alexander1810/Diplom/(list of files, drawings)

Other design files:
Diplom_test.pdsprj
