alexander1810/Diplom/Diplom/Diplom.ioc

Mcu.UserName=STM32F103C8Tx
PA10.GPIO_Label=PWM_PUMP
PA10.Signal=GPIO_Output
PA11.Signal=S_TIM1_CH4
PA13.Signal=SYS_JTMS-SWDIO
PA14.Signal=SYS_JTCK-SWCLK
PA2.Signal=USART2_TX
PA3.Signal=USART2_RX
PA4.Signal=ADCx_IN4
PA5.Signal=ADCx_IN5
PA6.Signal=ADCx_IN6
PA7.GPIO_Label=PWM_SWITCH
PA7.Signal=GPIO_Output
PA8.GPIO_Label=CONTROL_CH_HEATER
PA8.Signal=GPIO_Output
PA9.GPIO_Label=CONTROL_FAN
PA9.Signal=GPIO_Output
PB0.GPIO_Label=CONTROL_Cooler
PB0.Signal=GPIO_Output
PB1.GPIO_Label=CONTROL_Hum
PB1.Signal=GPIO_Output
PB10.GPIO_Label=CONTROL_WPoolPump
PB10.Signal=GPIO_Output
PB11.GPIO_Label=CONTROL_WH
PB11.Signal=GPIO_Output
PB3.Signal=GPXTI3
PC13-TAMPER-RTC.Signal=GPIO_Output
PC14-OSC32_IN.Signal=RCC_OSC32_IN
PC15-OSC32_OUT.Signal=RCC_OSC32_OUT
PD0-OSC_IN.Signal=RCC_OSC_IN
PD1-OSC_OUT.Signal=RCC_OSC_OUT
