alexander1810/Diplom/Diplom/Inc/main.h

#define BUF_SIZE 256
#define POOLTEMP_UPLIM 26
#define POOLTEMP_LOWLIM 24
#define PWM_SWITCH_Pin GPIO_PIN_7
#define PWM_SWITCH_GPIO_Port GPIOA
#define CONTROL_Cooler_Pin GPIO_PIN_0
#define CONTROL_Cooler_GPIO_Port GPIOB
#define CONTROL_Hum_Pin GPIO_PIN_1
#define CONTROL_Hum_GPIO_Port GPIOB
#define CONTROL_WPoolPump_Pin GPIO_PIN_10
#define CONTROL_WPoolPump_GPIO_Port GPIOB
#define CONTROL_WH_Pin GPIO_PIN_11
#define CONTROL_WH_GPIO_Port GPIOB
#define CONTROL_CH_HEATER_Pin GPIO_PIN_8
#define CONTROL_CH_HEATER_GPIO_Port GPIOA
#define CONTROL_FAN_Pin GPIO_PIN_9
#define CONTROL_FAN_GPIO_Port GPIOA
#define PWM_PUMP_Pin GPIO_PIN_10
#define PWM_PUMP_GPIO_Port GPIOA
