alexander1810/Diplom/Diplom/Src/usart.c

/**
  ******************************************************************************
  * File Name          : USART.c
  * Description        : This file provides code for the configuration
  *                      of the USART instances.
  ******************************************************************************
  * @attention
  *
  * <h2><center>&copy; Copyright (c) 2020 STMicroelectronics.
  * All rights reserved.</center></h2>
  *
  * This software component is licensed by ST under BSD 3-Clause license,
  * the "License"; You may not use this file except in compliance with the
  * License. You may obtain a copy of the License at:
  *                        opensource.org/licenses/BSD-3-Clause
  *
  ******************************************************************************
  */

/* Includes ------------------------------------------------------------------*/
#include "usart.h"

/* USER CODE BEGIN 0 */
/////////////////// GSM USART /////////////////////
volatile gsm_rx_buffer_index_t gsm_rx_buffer_head = 0;
volatile gsm_rx_buffer_index_t gsm_rx_buffer_tail = 0;
uint8_t gsm_rx_buffer[GSM_RX_BUFFER_SIZE] = {0,};

int16_t gsm_available(void)
{
	return ((uint16_t)(GSM_RX_BUFFER_SIZE + gsm_rx_buffer_head - gsm_rx_buffer_tail)) % GSM_RX_BUFFER_SIZE;
}

int16_t gsm_read(void)
{
	if(gsm_rx_buffer_head == gsm_rx_buffer_tail)
	{
		return -1;
	}
	else
	{
		unsigned char c = gsm_rx_buffer[gsm_rx_buffer_tail];
		gsm_rx_buffer_tail = (gsm_rx_buffer_index_t)(gsm_rx_buffer_tail + 1) % GSM_RX_BUFFER_SIZE;
		return c;
	}
}

/////////////////// DEBUG USART //////////////////// можно удалить после отладки всего

volatile dbg_rx_buffer_index_t dbg_rx_buffer_head = 0;
volatile dbg_rx_buffer_index_t dbg_rx_buffer_tail = 0;
uint8_t dbg_rx_buffer[DBG_RX_BUFFER_SIZE] = {0,};

int16_t dbg_available(void)
{
	return ((uint16_t)(DBG_RX_BUFFER_SIZE + dbg_rx_buffer_head - dbg_rx_buffer_tail)) % DBG_RX_BUFFER_SIZE;
}

int16_t dbg_read(void)
{
	if(dbg_rx_buffer_head == dbg_rx_buffer_tail)
	{
		return -1;
	}
	else
	{
		uint8_t c = dbg_rx_buffer[dbg_rx_buffer_tail];
		dbg_rx_buffer_tail = (dbg_rx_buffer_index_t)(dbg_rx_buffer_tail + 1) % DBG_RX_BUFFER_SIZE;
		return c;
	}
}

/* USER CODE END 0 */

UART_HandleTypeDef huart2;
DMA_HandleTypeDef hdma_usart2_rx;

/* USART2 init function */

void MX_USART2_UART_Init(void)
{

  huart2.Instance = USART2;
  huart2.Init.BaudRate = 9600;
  huart2.Init.WordLength = UART_WORDLENGTH_8B;
  huart2.Init.StopBits = UART_STOPBITS_1;
  huart2.Init.Parity = UART_PARITY_NONE;
  huart2.Init.Mode = UART_MODE_TX_RX;
  huart2.Init.HwFlowCtl = UART_HWCONTROL_NONE;
  huart2.Init.OverSampling = UART_OVERSAMPLING_16;
  if (HAL_UART_Init(&huart2) != HAL_OK)
  {
    Error_Handler();
  }

}

void HAL_UART_MspInit(UART_HandleTypeDef* uartHandle)
{

  GPIO_InitTypeDef GPIO_InitStruct = {0};
  if(uartHandle->Instance==USART2)
  {
    /* USART2 clock enable */
    __HAL_RCC_USART2_CLK_ENABLE();
  
    __HAL_RCC_GPIOA_CLK_ENABLE();
    /**USART2 GPIO Configuration    
    PA2     ------> USART2_TX
    PA3     ------> USART2_RX 
    */
    GPIO_InitStruct.Pin = GPIO_PIN_2;
    GPIO_InitStruct.Mode = GPIO_MODE_AF_PP;
    GPIO_InitStruct.Speed = GPIO_SPEED_FREQ_HIGH;
    HAL_GPIO_Init(GPIOA, &GPIO_InitStruct);

    GPIO_InitStruct.Pin = GPIO_PIN_3;
    GPIO_InitStruct.Mode = GPIO_MODE_INPUT;
    GPIO_InitStruct.Pull = GPIO_NOPULL;
    HAL_GPIO_Init(GPIOA, &GPIO_InitStruct);

    /* USART2 DMA Init */
    /* USART2_RX Init */
    hdma_usart2_rx.Instance = DMA1_Channel6;
    hdma_usart2_rx.Init.Direction = DMA_PERIPH_TO_MEMORY;
    hdma_usart2_rx.Init.PeriphInc = DMA_PINC_DISABLE;
    hdma_usart2_rx.Init.MemInc = DMA_MINC_ENABLE;
    hdma_usart2_rx.Init.PeriphDataAlignment = DMA_PDATAALIGN_BYTE;
    hdma_usart2_rx.Init.MemDataAlignment = DMA_MDATAALIGN_BYTE;
    hdma_usart2_rx.Init.Mode = DMA_CIRCULAR;
    hdma_usart2_rx.Init.Priority = DMA_PRIORITY_LOW;
    if (HAL_DMA_Init(&hdma_usart2_rx) != HAL_OK)
    {
      Error_Handler();
    }

    __HAL_LINKDMA(uartHandle,hdmarx,hdma_usart2_rx);

  }
}

void HAL_UART_MspDeInit(UART_HandleTypeDef* uartHandle)
{

  if(uartHandle->Instance==USART2)
  {
    /* Peripheral clock disable */
    __HAL_RCC_USART2_CLK_DISABLE();
  
    /**USART2 GPIO Configuration    
    PA2     ------> USART2_TX
    PA3     ------> USART2_RX 
    */
    HAL_GPIO_DeInit(GPIOA, GPIO_PIN_2|GPIO_PIN_3);

    /* USART2 DMA DeInit */
    HAL_DMA_DeInit(uartHandle->hdmarx);
  }
} 

/************************ (C) COPYRIGHT STMicroelectronics *****END OF FILE****/
