alexander1810/Diplom/Diplom/Src/dht_22.c

#include "gpio.h"
#include "dht_22.h"
#include "dwt.h"

/*********************************** DHT11 FUNCTIONS ********************************************/


void DHT11_Start (void)
{
	Set_Pin_Output (DHT11_PORT, DHT11_PIN);  // set the pin as output
	HAL_GPIO_WritePin (DHT11_PORT, DHT11_PIN, 0);   // pull the pin low
	DWT_Delay_us (18000);   // wait for 18ms
    HAL_GPIO_WritePin (DHT11_PORT, DHT11_PIN, 1);   // pull the pin high
    DWT_Delay_us (20);   // wait for 20us
	Set_Pin_Input(DHT11_PORT, DHT11_PIN);    // set as input
}

uint8_t DHT11_Check_Response (void)
{
	uint8_t Response = 0;
	DWT_Delay_us (40);
	if (!(HAL_GPIO_ReadPin (DHT11_PORT, DHT11_PIN)))
	{
		DWT_Delay_us (80);
		if ((HAL_GPIO_ReadPin (DHT11_PORT, DHT11_PIN))) Response = 1;
		else Response = -1; // 255
	}
	while ((HAL_GPIO_ReadPin (DHT11_PORT, DHT11_PIN)));   // wait for the pin to go low

	return Response;
}

uint8_t DHT11_Read (void)
{
	uint8_t i,j;
	for (j=0;j<8;j++)
	{
		while (!(HAL_GPIO_ReadPin (DHT11_PORT, DHT11_PIN)));   // wait for the pin to go high
		DWT_Delay_us (40);   // wait for 40 us
		if (!(HAL_GPIO_ReadPin (DHT11_PORT, DHT11_PIN)))   // if the pin is low
		{
			i&= ~(1<<(7-j));   // write 0
		}
		else i|= (1<<(7-j));  // if the pin is high, write 1
		while ((HAL_GPIO_ReadPin (DHT11_PORT, DHT11_PIN)));  // wait for the pin to go low
	}
	return i;
}
