alexander1810/Diplom/Diplom/Src/ds18b20.c

#include "ds18b20.h"
#include "gpio.h"
#include "dwt.h"

uint8_t DS18B20_Start (void)
{
	uint8_t Response = 0;
	Set_Pin_Output(DS18B20_PORT, DS18B20_PIN);   // set the pin as output
	HAL_GPIO_WritePin (DS18B20_PORT, DS18B20_PIN, 0);  // pull the pin low
	DWT_Delay_us (480);   // delay according to datasheet

	Set_Pin_Input(DS18B20_PORT, DS18B20_PIN);    // set the pin as input
	DWT_Delay_us (80);    // delay according to datasheet

	if (!(HAL_GPIO_ReadPin (DS18B20_PORT, DS18B20_PIN))) Response = 1;    // if the pin is low i.e the presence pulse is detected
	else Response = -1;

	DWT_Delay_us (400); // 480 us delay totally.

	return Response;
}

void DS18B20_Write (uint8_t data)
{
	Set_Pin_Output(DS18B20_PORT, DS18B20_PIN);  // set as output

	for (int i=0; i<8; i++)
	{

		if ((data & (1<<i))!=0)  // if the bit is high
		{
			// write 1

			Set_Pin_Output(DS18B20_PORT, DS18B20_PIN);  // set as output
			HAL_GPIO_WritePin (DS18B20_PORT, DS18B20_PIN, 0);  // pull the pin LOW
			DWT_Delay_us (1);  // wait for 1 us

			Set_Pin_Input(DS18B20_PORT, DS18B20_PIN);  // set as input
			DWT_Delay_us (50);  // wait for 60 us
		}

		else  // if the bit is low
		{
			// write 0

			Set_Pin_Output(DS18B20_PORT, DS18B20_PIN);
			HAL_GPIO_WritePin (DS18B20_PORT, DS18B20_PIN, 0);  // pull the pin LOW
			DWT_Delay_us (50);  // wait for 60 us

			Set_Pin_Input(DS18B20_PORT, DS18B20_PIN);
		}
	}
}

uint8_t DS18B20_Read (void)
{
	uint8_t value=0;

	Set_Pin_Input(DS18B20_PORT, DS18B20_PIN);

	for (int i=0;i<8;i++)
	{
		Set_Pin_Output(DS18B20_PORT, DS18B20_PIN);   // set as output

		HAL_GPIO_WritePin (DS18B20_PORT, DS18B20_PIN, 0);  // pull the data pin LOW
		DWT_Delay_us (1);  // wait for > 1us

		Set_Pin_Input(DS18B20_PORT, DS18B20_PIN);  // set as input
		if (HAL_GPIO_ReadPin (DS18B20_PORT, DS18B20_PIN))  // if the pin is HIGH
		{
			value |= 1<<i;  // read = 1
		}
		DWT_Delay_us (50);  // wait for 60 us
	}
	return value;
}
